andrey-pr/TorpedoZeroHW/board/BOM.ods

Наименование | Необх. Кол-во | Кол-во в заказе | Лот
Печатная плата | 1 | 5 | https://jlcpcb.com/
adxl345 | 1 | 10 | https://aliexpress.ru/item/33046120653.html
Конденсатор 0.1uF 0805 | 4 | 50 | https://voron.ua/catalog/036044--kondensator_0805_100nf_50v_x7r_cc0805krx7r9bb104_yageo_yageo_corporation_0805_08 | .
Резистор 10K 0805 | 4 | 100 | https://voron.ua/catalog/002189--rezistor_smd_10k_0805_1_0805_0805
Резистор 30K 0805 | 3 | 100 | https://voron.ua/catalog/031446--rezistor_smd_30k_0805_1_0805_0805
Потенциометр 10K | 1 | 5 | https://voron.ua/catalog/001623--rezistor_podstroechnyy_10k_3296w
PLS-40 | 1 | 2 | https://voron.ua/catalog/000631--mezhplatnyy_soedinitel_pls40-g
Джампер | 2 | 100 | https://aliexpress.ru/item/4000540718136.html
Резистор 20K 0805 | 1 | 100 | https://voron.ua/catalog/002301--rezistor_smd_20k_0805_1_0805_0805
Резистор 4.99K 0805 | 1 | 100 | https://voron.ua/catalog/028673--rezistor_smd_499k_0805_1_0805_0805
Резистор 330 0805 | 1 | 100 | https://voron.ua/catalog/031450--rezistor_smd_332r_0805_1_0805_0805
Светодиод 1206 | 1 | 10 | https://voron.ua/catalog/038170
Sim800l | 1 | 3 | https://aliexpress.ru/item/32622274840.html
Кварц 8мгц | 1 | 5 | https://voron.ua/catalog/002968--kvartsevyy_rezonator_8mhz_hc49s_kor_hc49s_hc49s
Конденсатор 15pF 0805 | 2 | 50 | https://voron.ua/catalog/001852--kondensator_0805_15pf_50v_np0_cl21c150jbannnc_samsung_samsung_electronics_0805_0
Atmega328 | 1 | 5 | https://aliexpress.ru/item/4000064299962.html
18650 | 1 | 2 | https://aliexpress.ru/item/32854136845.html
Саморез М3x4 | 2 | 50 | https://voron.ua/catalog/036187--samorez-vint_m3h4mm_s_zakruglennoy_golovkoy_nikelirovannyy
TP4056 | 1 | 5 | https://aliexpress.ru/item/32986135934.html
Заглушка для разъемов | 1 | 25 | https://aliexpress.ru/item/33019739380.html
Выключатель | 1 | 0 | https://voron.ua/catalog/012612--pereklyuchatel_polzunkovyy_ss22f32
