andrey-pr/TorpedoZeroHW/case/3d-components/Generic 18650 Battery v1.step

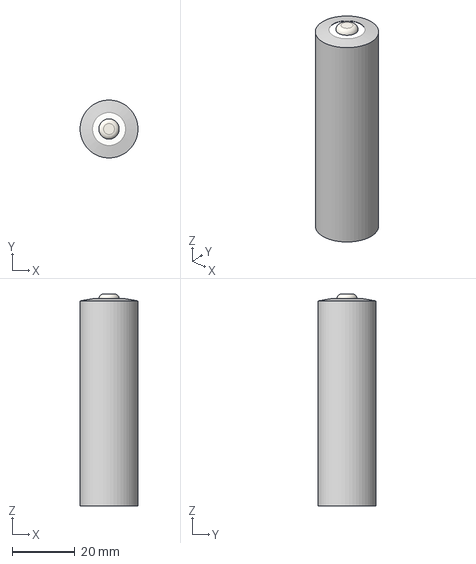
[picture p1: CAD file, 2021-03-11]
case/3d-components/Generic 18650 Battery v1.step
18.5 x 18.5 x 67.7 mm
