andrey-pr/TorpedoZeroHW/case/TorpedoZero.FCStd

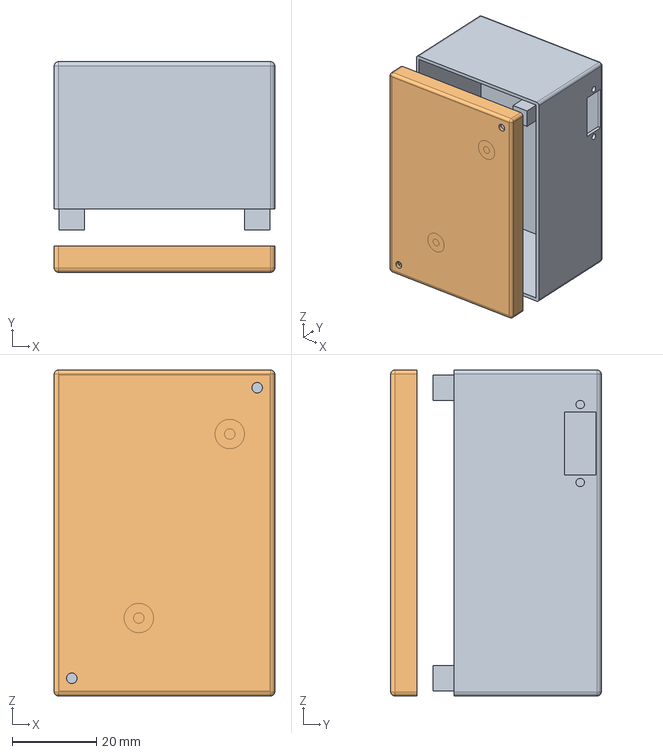
[picture p2: CAD file, 2021-03-11]
case/TorpedoZero.FCStd
52.4 x 50.0 x 77.4 mm
