andrey-pr/TorpedoZeroHW/case/3d-components/board.step

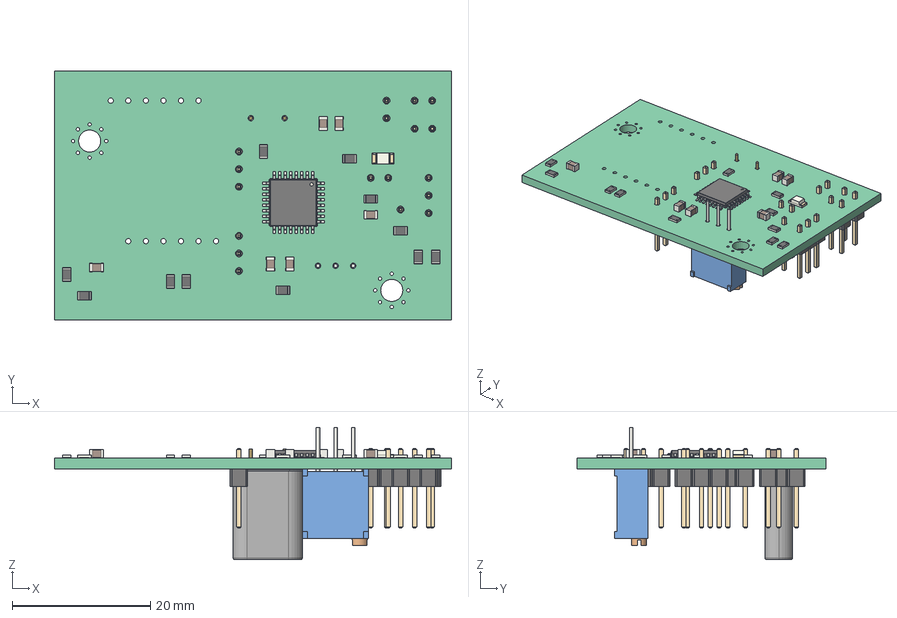
[picture p3: CAD file, 2021-03-11]
case/3d-components/board.step
57.4 x 36.1 x 19.1 mm
Local_CS_f1e1
Pcb_f1e1
PCB_Sketch_f1e1
R11_R_0805_2012Metric_5F516B74
R10_R_0805_2012Metric_5F516B63
U2_TQFP_32_7x7mm_P08mm_5F511C14
R9_R_0805_2012Metric_5F5118E0
R8_R_0805_2012Metric_5F5118CF
R7_R_0805_2012Metric_5F5118BE
R6_R_0805_2012Metric_5F5118AD
R5_R_0805_2012Metric_5F51189C
R4_R_0805_2012Metric_5F51188B
R3_R_0805_2012Metric_5F51187A
R2_R_0805_2012Metric_5F511869
R1_R_0805_2012Metric_5F511858
D1_LED_1206_3216Metric_5F5117A5
C6_C_0805_2012Metric_5F511792
C5_C_0805_2012Metric_5F511781
C4_C_0805_2012Metric_5F511770
C3_C_0805_2012Metric_5F51175F
C2_C_0805_2012Metric_5F51174E
C1_C_0805_2012Metric_5F51173D
J6_PinHeader_1x02_P254mm_Vertical_5F51B11B
J5_PinHeader_1x02_P254mm_Vertical_5F51B105
Y1_Crystal_HC49-U_Vertical_5F511C2B
RV1_Potentiometer_Bourns_3296W_Vertical_5F5118F7
JP2_PinHeader_1x03_P254mm_Vertical_5F511847
JP1_PinHeader_1x03_P254mm_Vertical_5F511830
J4_PinHeader_1x02_P254mm_Vertical_5F511819
J3_PinHeader_1x01_P254mm_Vertical_5F511803
J2_PinHeader_1x02_P254mm_Vertical_5F5117EE
J1_PinHeader_1x03_P254mm_Vertical_5F5117D8
