andrey-pr/TorpedoZeroHW/board/TorpedoZero.kicad_pcb

## KiCad design board/TorpedoZero.kicad_pcb (2021-03-11)

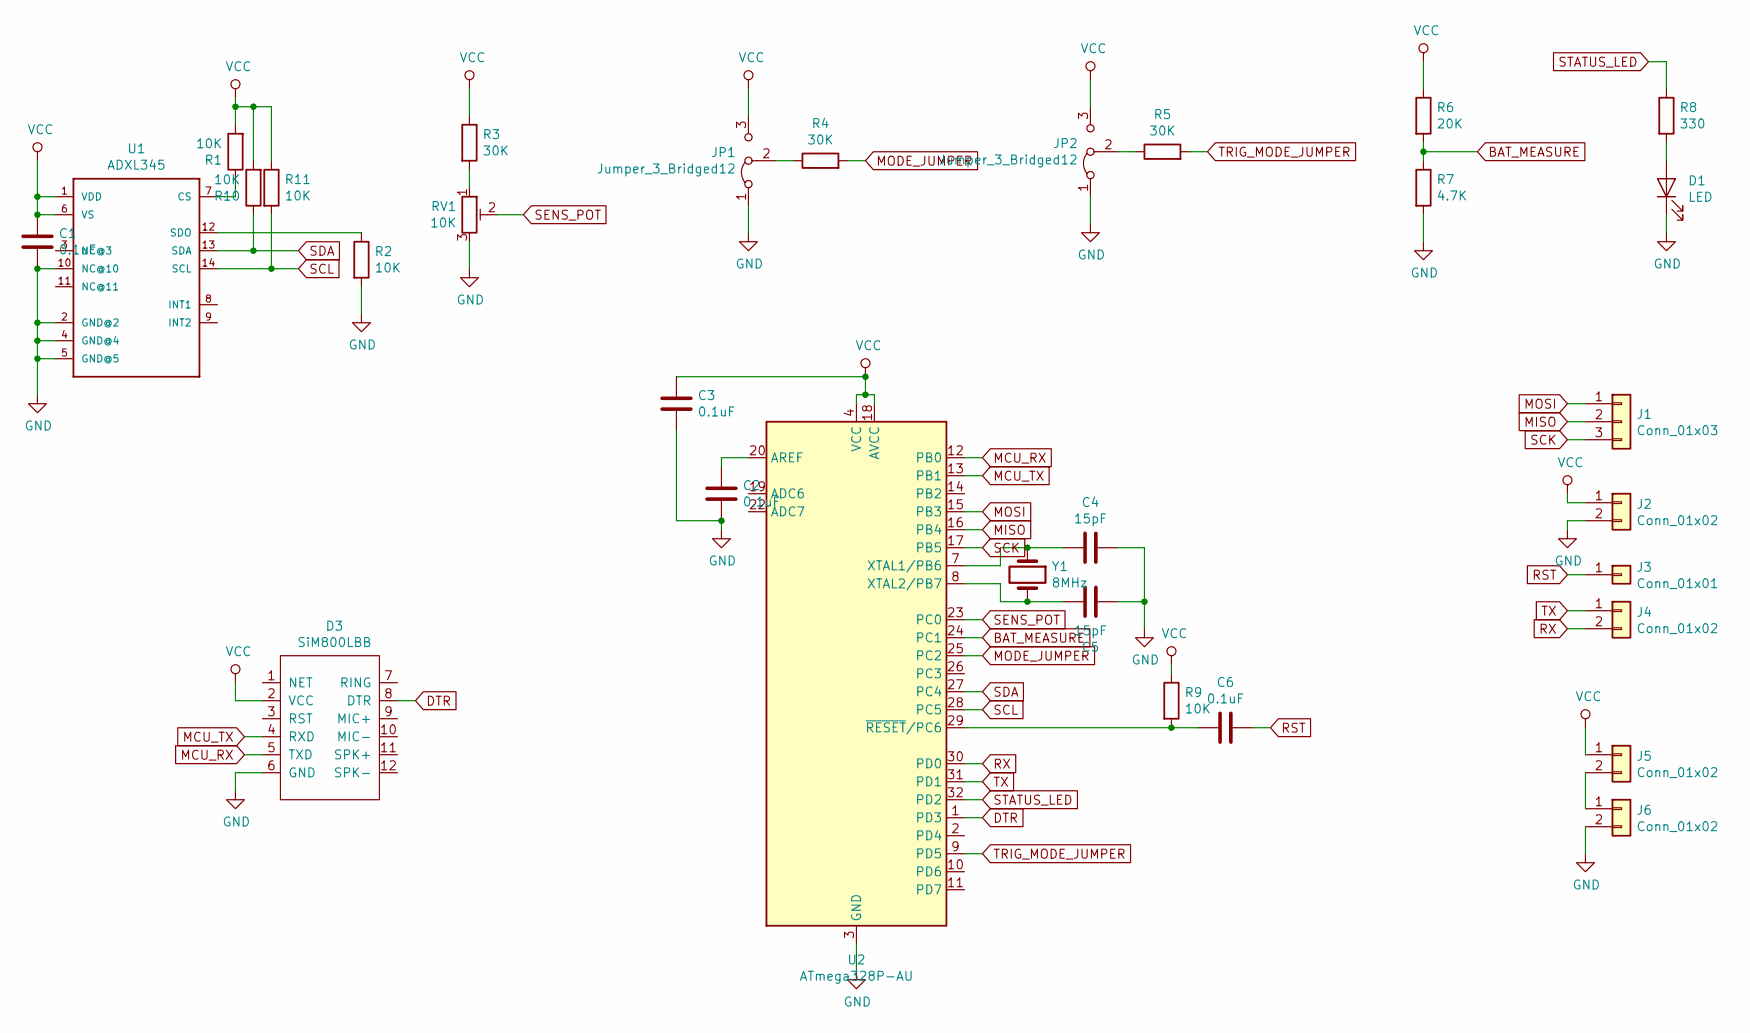
[picture p4: schematic TorpedoZero.sch]

Parts:
C1, C2, C3, C6: 0.1uF; C_0805_2012Metric_Pad1.15x1.40mm_HandSolder
C4, C5: 15pF; C_0805_2012Metric_Pad1.15x1.40mm_HandSolder
D1: LED; LED_1206_3216Metric_Pad1.42x1.75mm_HandSolder
D3: SiM800LBB; SIM800lBB
J1: Conn_01x03; PinHeader_1x03_P2.54mm_Vertical
J2, J4, J5, J6: Conn_01x02; PinHeader_1x02_P2.54mm_Vertical
J3: Conn_01x01; PinHeader_1x01_P2.54mm_Vertical
JP1, JP2: Jumper_3_Bridged12; PinHeader_1x03_P2.54mm_Vertical
R1, R2, R9, R10, R11: 10K; R_0805_2012Metric_Pad1.15x1.40mm_HandSolder
R3, R4, R5: 30K; R_0805_2012Metric_Pad1.15x1.40mm_HandSolder
R6: 20K; R_0805_2012Metric_Pad1.15x1.40mm_HandSolder
R7: 4.7K; R_0805_2012Metric_Pad1.15x1.40mm_HandSolder
R8: 330; R_0805_2012Metric_Pad1.15x1.40mm_HandSolder
RV1: 10K; Potentiometer_Bourns_3296W_Vertical
U1: ADXL345; LGA-14
U2: ATmega328P-AU; TQFP-32_7x7mm_P0.8mm
Y1: 8MHz; Crystal_HC49-U_Vertical

Connections:
BAT_MEASURE: R6.2, R7.1, U2.24 (PC1)
DTR: D3.8 (DTR), U2.1 (PD3)
GND: C1.2, C2.1, C3.1, C4.1, C5.2, D1.1 (K), D3.6 (GND), J2.2, J6.2, JP1.1 (A), JP2.1 (A), R2.2, R7.2, RV1.3, U1.2 (GND@2), U1.4 (GND@4), U1.5 (GND@5), U1.10 (NC@10), U2.3 (GND), U2.5 (GND), U2.21 (GND)
MCU_RX: D3.5 (TXD), U2.12 (PB0)
MCU_TX: D3.4 (RXD), U2.13 (PB1)
MISO: J1.2, U2.16 (PB4)
MODE_JUMPER: R4.2, U2.25 (PC2)
MOSI: J1.1, U2.15 (PB3)
unnamed: C2.2, U2.20 (AREF)
unnamed: C4.2, U2.7 (XTAL1/PB6), Y1.1
unnamed: C5.1, U2.8 (XTAL2/PB7), Y1.2
unnamed: C6.2, R9.2, U2.29 (~RESET~/PC6)
unnamed: D1.2 (A), R8.2
unnamed: J5.2, J6.1
unnamed: JP1.2 (C), R4.1
unnamed: JP2.2 (C), R5.1
unnamed: R1.1, U1.7 (CS)
unnamed: R2.1, U1.12 (SDO)
unnamed: R3.2, RV1.1
RST: C6.1, J3.1; also elsewhere on the board
RX: J4.2, U2.30 (PD0)
SCK: J1.3, U2.17 (PB5)
SCL: R11.2, U1.14 (SCL), U2.28 (PC5)
SDA: R10.1, U1.13 (SDA), U2.27 (PC4)
SENS_POT: RV1.2, U2.23 (PC0)
STATUS_LED: R8.1, U2.32 (PD2)
TRIG_MODE_JUMPER: R5.2, U2.9 (PD5)
TX: J4.1, U2.31 (PD1)
VCC: C1.1, C3.2, D3.2 (VCC), J2.1, J5.1, JP1.3 (B), JP2.3 (B), R1.2, R3.1, R6.1, R9.1, R10.2, R11.1, U1.1 (VDD), U1.6 (VS), U2.4 (VCC), U2.6 (VCC), U2.18 (AVCC)

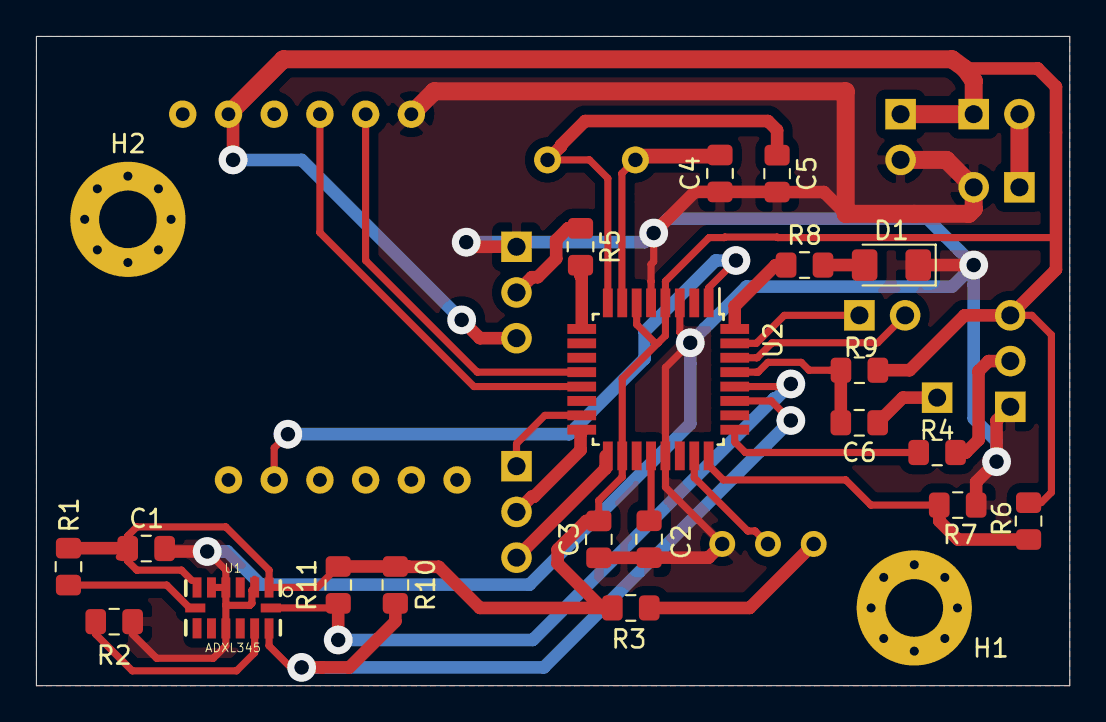
[picture p5: board TorpedoZero.kicad_pcb from above]

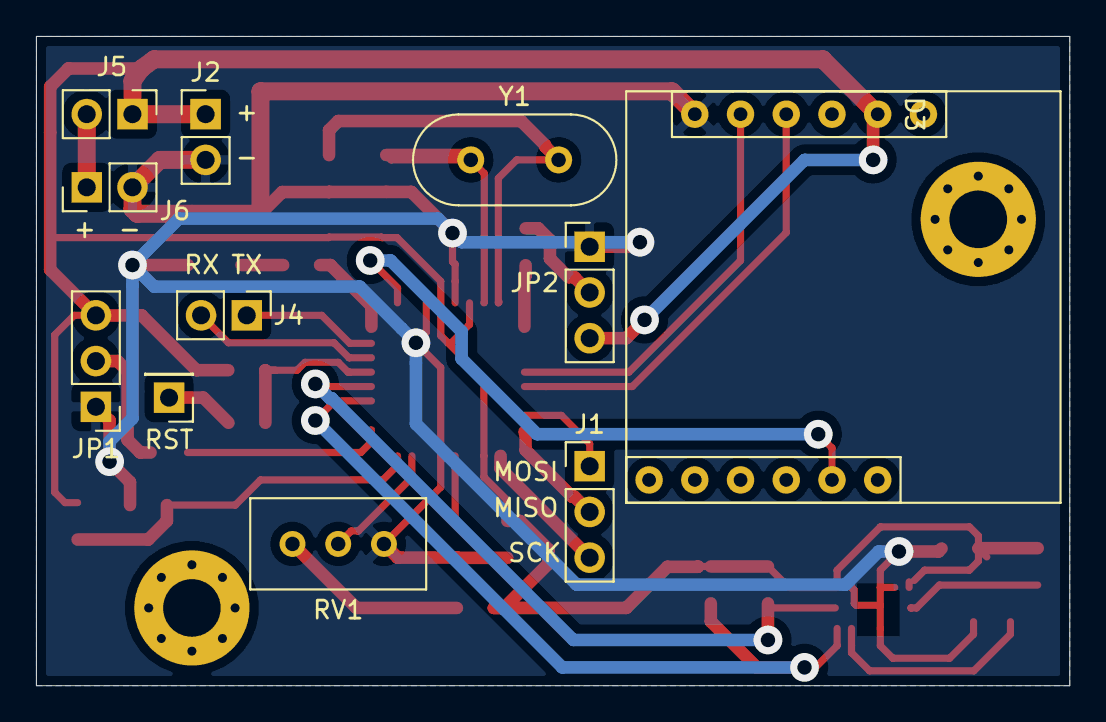
[picture p6: board TorpedoZero.kicad_pcb from below]

Board: 2 copper layers, 57.4 x 36.1 mm, 33 parts (11 on the bottom side), 29 nets.

Other parts of the board:
H1, H2: 3.2mm; MountingHole_3.2mm_M3_Pad_Via
RST: Conn_01x01; PinHeader_1x01_P2.54mm_Vertical

Their connections:
RST: RST.1; also elsewhere on the board
